kanengomibako/OwmPedal/OwmPedal_pic.jpg

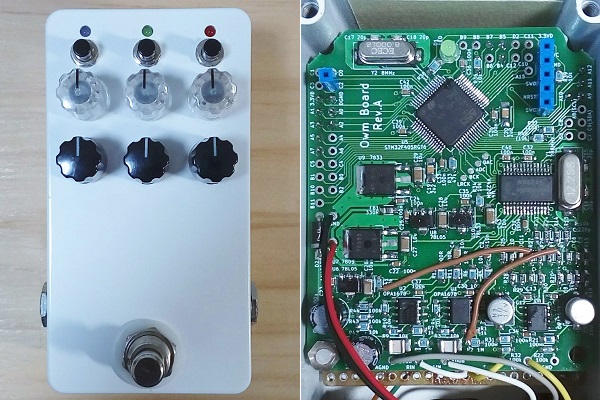
OwmPedal_pic.jpg
