kanengomibako/OwmPedal/README.txt

STM32F405 Digital Effects Pedal

STM32F405という32ビットマイコンを搭載した自作デジタルエフェクター「Owm Pedal」です。
