kanengomibako/OwmPedal/OwmBoard_sch.png

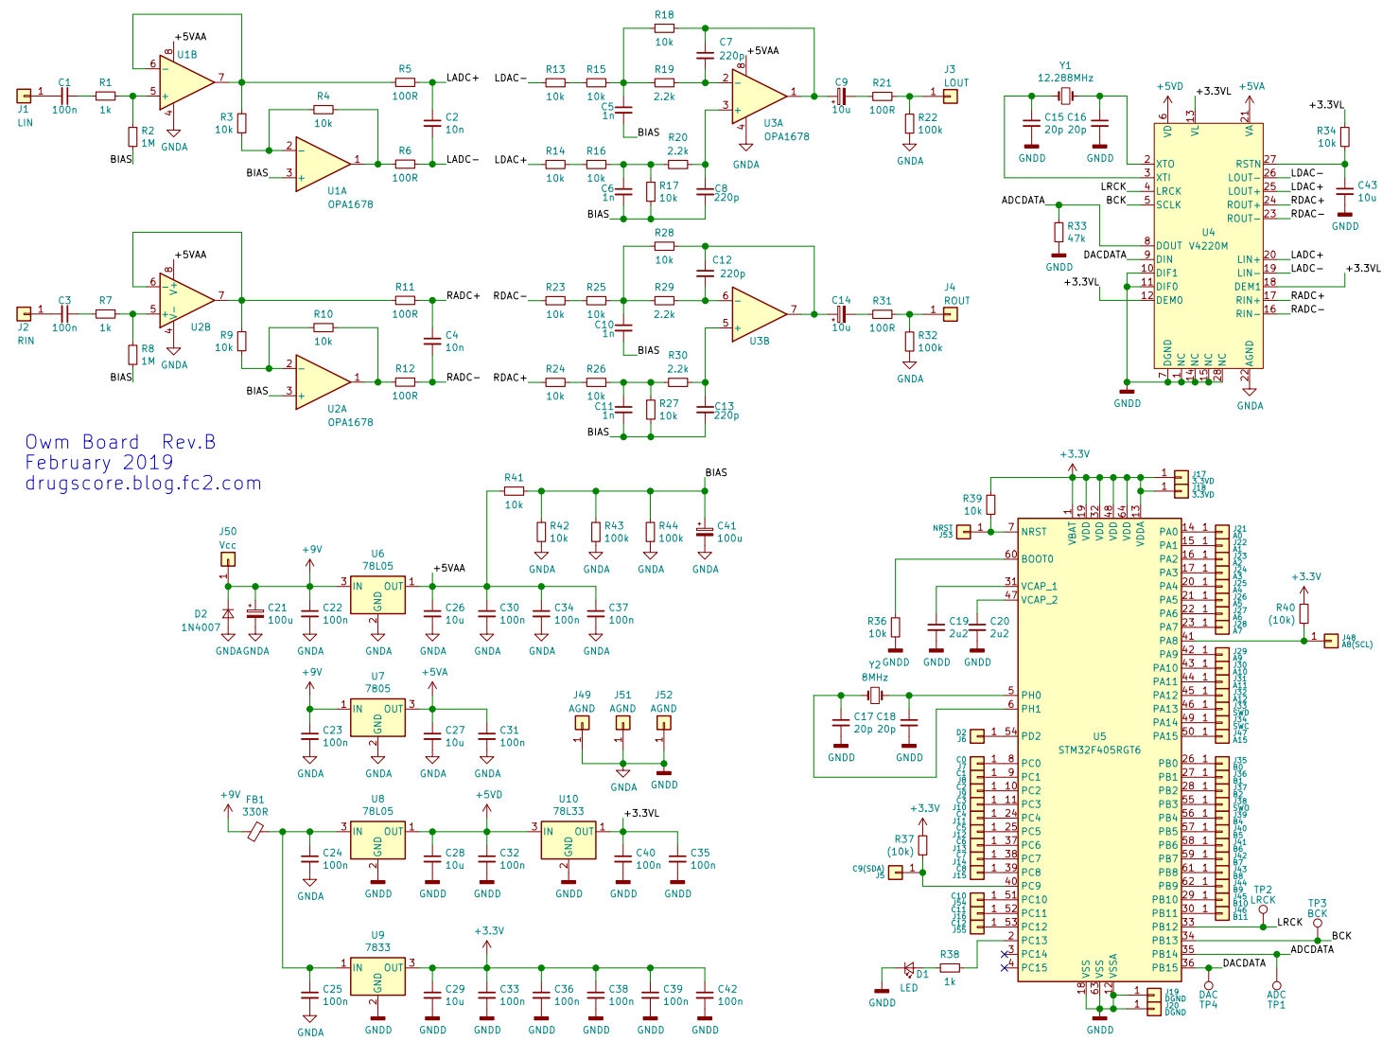
OwmBoard_sch.png
