kanengomibako/OwmPedal/KiCad/owm.kicad_pcb

## KiCad design KiCad/owm.kicad_pcb (2019-02-07)

Schematic: owm.sch

Parts:
C1, C3: 100n; my_C_3225(1210)_HandSoldering
C2, C4: 10n; my_C_1608(0603)_HandSoldering
C5, C6, C10, C11: 1n; my_C_1608(0603)_HandSoldering
C7, C8, C12, C13: 220p; my_C_1608(0603)_HandSoldering
C9, C14: 10u; my_CP_Elec_5
C15, C16, C17, C18: 20p; my_C_1608(0603)_HandSoldering
C19, C20: 2u2; my_C_3216(1206)_HandSoldering
C21, C41: 100u; my_C_D6.3mm_P2.50mm
C22, C23, C24, C25, C30, C31, C32, C33, C34, C35, C36, C37, C38, C39, C40, C42: 100n; my_C_1608(0603)_HandSoldering
C26, C27, C28, C29, C43: 10u; my_C_3216(1206)_HandSoldering
D1: LED; LED_D3.0mm
D2: 1N4007; D_DO-35_SOD27_P7.62mm_Horizontal
FB1: 330R; my_R_2012(0805)_HandSoldering
J1: LIN; my_SmallPad_0-8mmDrill
J2: RIN; my_SmallPad_0-8mmDrill
J3: LOUT; my_SmallPad_0-8mmDrill
J4: ROUT; my_SmallPad_0-8mmDrill
J5: C9(SDA); my_SmallPad_0-8mmDrill
J6: D2; my_SmallPad_0-8mmDrill
J7: C0; my_SmallPad_0-8mmDrill
J8: C1; my_SmallPad_0-8mmDrill
J9: C2; my_SmallPad_0-8mmDrill
J10: C3; my_SmallPad_0-8mmDrill
J11: C4; my_SmallPad_0-8mmDrill
J12: C5; my_SmallPad_0-8mmDrill
J13: C6; my_SmallPad_0-8mmDrill
J14: C7; my_SmallPad_0-8mmDrill
J15: C8; my_SmallPad_0-8mmDrill
J16: C11; my_SmallPad_0-8mmDrill
J17, J18: 3.3VD; my_SmallPad_0-8mmDrill
J19, J20: DGND; my_SmallPad_0-8mmDrill
J21: A0; my_SmallPad_0-8mmDrill
J22: A1; my_SmallPad_0-8mmDrill
J23: A2; my_SmallPad_0-8mmDrill
J24: A3; my_SmallPad_0-8mmDrill
J25: A4; my_SmallPad_0-8mmDrill
J26: A5; my_SmallPad_0-8mmDrill
J27: A6; my_SmallPad_0-8mmDrill
J28: A7; my_SmallPad_0-8mmDrill
J29: A9; my_SmallPad_0-8mmDrill
J30: A10; my_SmallPad_0-8mmDrill
J31: A11; my_SmallPad_0-8mmDrill
J32: A12; my_SmallPad_0-8mmDrill
J33: SWD; my_SmallPad_0-8mmDrill
J34: SWC; my_SmallPad_0-8mmDrill
J35: B0; my_SmallPad_0-8mmDrill
J36: B1; my_SmallPad_0-8mmDrill
J37: B2; my_SmallPad_0-8mmDrill
J38: SWO; my_SmallPad_0-8mmDrill
J39: B4; my_SmallPad_0-8mmDrill
J40: B5; my_SmallPad_0-8mmDrill
J41: B6; my_SmallPad_0-8mmDrill
J42: B7; my_SmallPad_0-8mmDrill
J43: B8; my_SmallPad_0-8mmDrill
J44: B9; my_SmallPad_0-8mmDrill
J45: B10; my_SmallPad_0-8mmDrill
J46: B11; my_SmallPad_0-8mmDrill
J47: A15; my_SmallPad_0-8mmDrill
J48: A8(SCL); my_SmallPad_0-8mmDrill
J49, J51, J52: AGND; my_SmallPad_0-8mmDrill
J50: Vcc; my_SmallPad_0-8mmDrill
J53: NRST; my_SmallPad_0-8mmDrill
J54: C10; my_SmallPad_0-8mmDrill
J55: C12; my_SmallPad_0-8mmDrill
R1, R7, R38: 1k; my_R_2012(0805)_HandSoldering
R2, R8: 1M; my_R_1608(0603)_HandSoldering
R3, R4, R9, R10, R13, R14, R15, R16, R17, R18, R23, R24, R25, R26, R27, R28, R34, R36, R39, R41, R42: 10k; my_R_1608(0603)_HandSoldering
R5, R6, R11, R12, R21, R31: 100R; my_R_2012(0805)_HandSoldering
R19, R20, R29, R30: 2.2k; my_R_1608(0603)_HandSoldering
R22, R32, R43, R44: 100k; my_R_1608(0603)_HandSoldering
R33: 47k; my_R_1608(0603)_HandSoldering
R37, R40: (10k); my_R_1608(0603)_HandSoldering
TP1: ADC; my_TestPoint_1.2mm
TP2: LRCK; my_TestPoint_1.2mm
TP3: BCK; my_TestPoint_1.2mm
TP4: DAC; my_TestPoint_1.2mm
U1, U2, U3: OPA1678; SOIC-8_3.9x4.9mm_P1.27mm
U4: V4220M; my_SSOP-28_5.3x10.2mm_Pitch0.65mm
U5: STM32F405RGT6; my_LQFP-64_10x10_P0.5
U6, U8: 78L05; SOT-89-3
U7: 7805; TO-252-3_TabPin2
U9: 7833; TO-252-3_TabPin2
U10: 78L33; SOT-89-3
Y1: 12.288MHz; Crystal_SMD_HC49-SD
Y2: 8MHz; Crystal_SMD_HC49-SD

Connections:
+3V3: C29.1, C33.1, C36.1, C38.1, C39.1, C42.1, J17.1, J18.1, R37.1, R39.1, R40.1, U5.1, U5.13, U5.19, U5.32, U5.48, U5.64, U9.3
+5VA: C27.1, C31.1, U4.21, U7.3
+5VD: C28.1, C32.1, U4.6, U8.1 (OUT), U10.3 (IN)
+9V: C21.1, C22.1, C23.1, D2.1, FB1.2, J50.1, U6.3 (IN), U7.1
/+3.3VL: C35.1, C40.1, R34.1, U4.12, U4.13, U4.18, U10.1 (OUT)
/+5VAA: C26.1, C30.1, C34.1, C37.1, R41.2, U1.8 (V+), U2.8 (V+), U3.8 (V+), U6.1 (OUT)
/ADCDATA: R33.1, TP1.1, U4.8, U5.35
/BCK: TP3.1, U4.5, U5.34
/BIAS: C5.2, C6.2, C8.2, C10.2, C11.2, C13.2, C41.1, R2.2, R8.2, R17.2, R27.2, R41.1, R42.1, R43.1, R44.1, U1.3 (+), U2.3 (+)
/DACDATA: TP4.1, U4.9, U5.36
/LADC+: C2.1, R5.1, U4.20
/LADC-: C2.2, R6.1, U4.19
/LDAC+: R14.2, U4.25
/LDAC-: R13.2, U4.26
/LRCK: TP2.1, U4.4, U5.33
/RADC+: C4.1, R11.1, U4.17
/RADC-: C4.2, R12.1, U4.16
/RDAC+: R24.2, U4.24
/RDAC-: R23.2, U4.23
GNDA: C15.2, C16.2, C17.2, C18.2, C19.2, C20.2, C21.2, C22.2, C23.2, C24.2, C25.2, C26.2, C27.2, C28.2, C29.2, C30.2, C31.2, C32.2, C33.2, C34.2, C35.2, C36.2, C37.2, C38.2, C39.2, C40.2, C41.2, C42.2, C43.2, D1.1, D2.2, J19.1, J20.1, J49.1, J51.1, J52.1, R22.2, R32.2, R33.2, R36.2, R42.2, R43.2, R44.2, U1.4 (V-), U2.4 (V-), U3.4 (V-), U4.1, U4.7, U4.10, U4.11, U4.14, U4.15, U4.22, U4.28, U5.12, U5.18, U5.63, U6.2 (GND), U7.2, U8.2 (GND), U9.2, U10.2 (GND)
unnamed: C1.1, R1.2
unnamed: C1.2, J1.1
unnamed: C3.1, R7.2
unnamed: C3.2, J2.1
unnamed: C5.1, R15.1, R18.2, R19.2
unnamed: C6.1, R16.1, R17.1, R20.2
unnamed: C7.1, C9.1, R18.1, U3.1
unnamed: C7.2, R19.1, U3.2 (-)
unnamed: C8.1, R20.1, U3.3 (+)
unnamed: C9.2, R21.2
unnamed: C10.1, R25.1, R28.2, R29.2
unnamed: C11.1, R26.1, R27.1, R30.2
unnamed: C12.1, C14.1, R28.1, U3.7
unnamed: C12.2, R29.1, U3.6 (-)
unnamed: C13.1, R30.1, U3.5 (+)
unnamed: C14.2, R31.2
unnamed: C15.1, U4.3, Y1.1
unnamed: C16.1, U4.2, Y1.2
unnamed: C17.1, U5.6, Y2.1
unnamed: C18.1, U5.5, Y2.2
unnamed: C19.1, U5.31
unnamed: C20.1, U5.47
unnamed: C24.1, C25.1, FB1.1, U8.3 (IN), U9.1
unnamed: C43.1, R34.2, U4.27
unnamed: D1.2, R38.1
unnamed: J3.1, R21.1, R22.1
unnamed: J4.1, R31.1, R32.1
unnamed: J5.1, R37.2, U5.40
unnamed: J6.1, U5.54
unnamed: J7.1, U5.8
unnamed: J8.1, U5.9
unnamed: J9.1, U5.10
unnamed: J10.1, U5.11
unnamed: J11.1, U5.24
unnamed: J12.1, U5.25
unnamed: J13.1, U5.37
unnamed: J14.1, U5.38
unnamed: J15.1, U5.39
unnamed: J16.1, U5.52
unnamed: J21.1, U5.14
unnamed: J22.1, U5.15
unnamed: J23.1, U5.16
unnamed: J24.1, U5.17
unnamed: J25.1, U5.20
unnamed: J26.1, U5.21
unnamed: J27.1, U5.22
unnamed: J28.1, U5.23
unnamed: J29.1, U5.42
unnamed: J30.1, U5.43
unnamed: J31.1, U5.44
unnamed: J32.1, U5.45
unnamed: J33.1, U5.46
unnamed: J34.1, U5.49
unnamed: J35.1, U5.26
unnamed: J36.1, U5.27
unnamed: J37.1, U5.28
unnamed: J38.1, U5.55
unnamed: J39.1, U5.56
unnamed: J40.1, U5.57
unnamed: J41.1, U5.58
unnamed: J42.1, U5.59
unnamed: J43.1, U5.61
unnamed: J44.1, U5.62
unnamed: J45.1, U5.29
unnamed: J46.1, U5.30
unnamed: J47.1, U5.50
unnamed: J48.1, R40.2, U5.41
unnamed: J53.1, R39.2, U5.7
unnamed: J54.1, U5.51
unnamed: J55.1, U5.53
unnamed: R1.1, R2.1, U1.5 (+)
unnamed: R3.1, R5.2, U1.6 (-), U1.7
unnamed: R3.2, R4.2, U1.2 (-)
unnamed: R4.1, R6.2, U1.1
unnamed: R7.1, R8.1, U2.5 (+)
unnamed: R10.1, R12.2, U2.1
unnamed: R9.2, R10.2, U2.2 (-)
unnamed: R9.1, R11.2, U2.6 (-), U2.7
unnamed: R13.1, R15.2
unnamed: R14.1, R16.2
unnamed: R23.1, R25.2
unnamed: R24.1, R26.2
unnamed: R36.1, U5.60
unnamed: R38.2, U5.2

Notes on the sheet:
Owm Board Rev.B February 2019 drugscore.blog.fc2.com

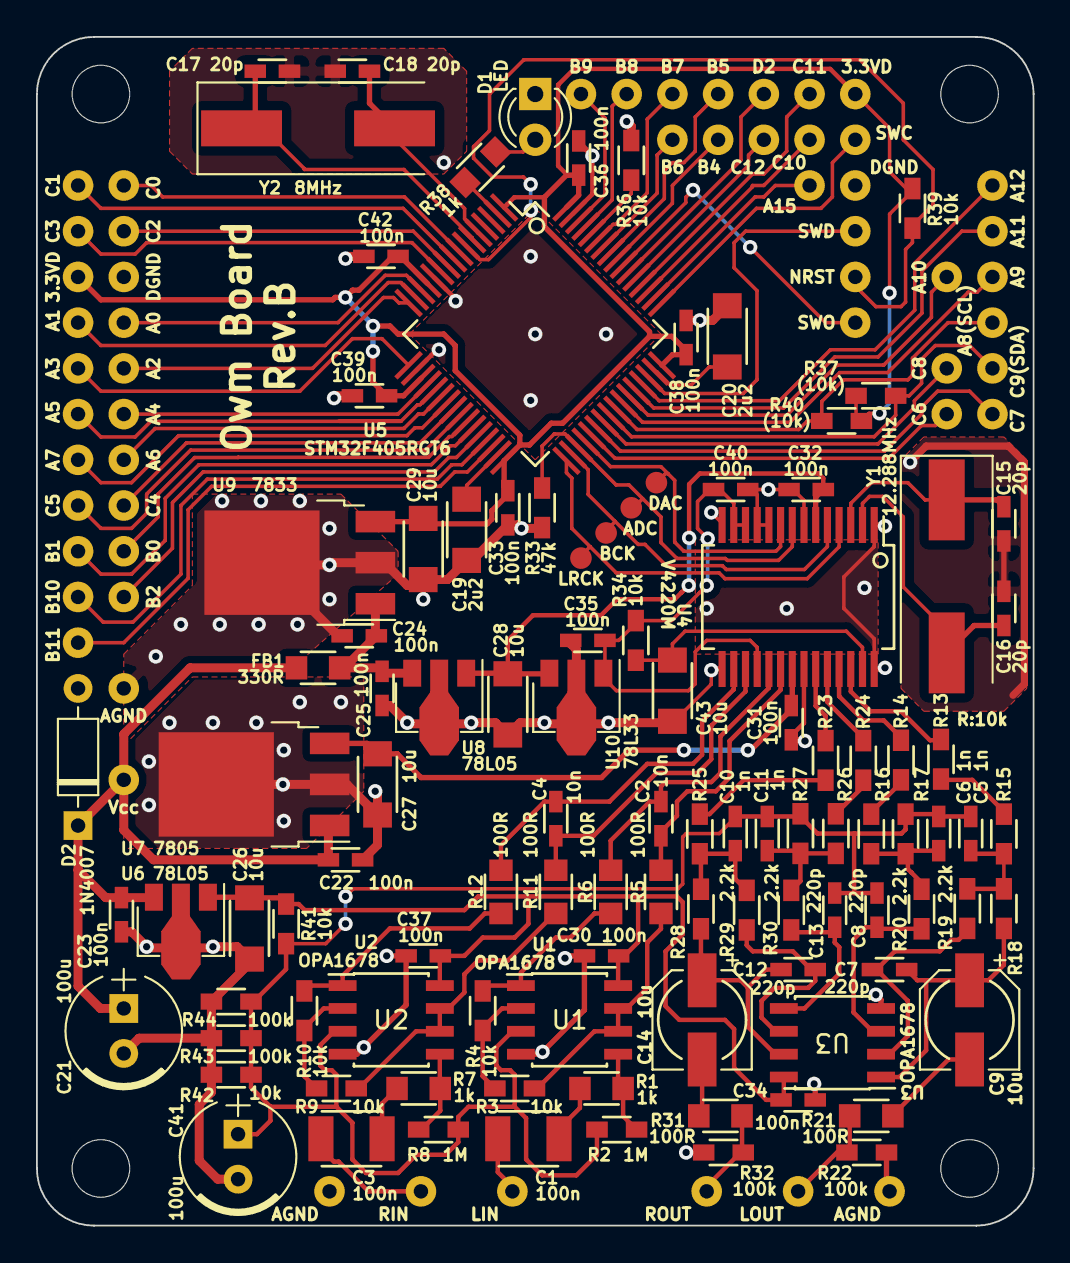
[picture p3: board owm.kicad_pcb from above]

Board: 2 copper layers, 55.4 x 66.0 mm, 160 parts (0 on the bottom side), 104 nets.
