kanengomibako/OwmPedal/Source/main.c

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

/* Includes ------------------------------------------------------------------*/
#include "main.h"

ADC_HandleTypeDef hadc1;
DMA_HandleTypeDef hdma_adc1;

I2S_HandleTypeDef hi2s2;
DMA_HandleTypeDef hdma_i2s2_ext_rx;
DMA_HandleTypeDef hdma_spi2_tx;

void SystemClock_Config(void);
static void MX_GPIO_Init(void);
static void MX_DMA_Init(void);
static void MX_ADC1_Init(void);
static void MX_I2S2_Init(void);
/* USER CODE BEGIN 0 */

volatile int32_t RX_BUFFER[BLOCK_SIZE*2] = {}; // 受信バッファ
volatile int32_t TX_BUFFER[BLOCK_SIZE*2] = {}; // 送信バッファ
volatile uint16_t pot[6] = {}; // ポット読取値
volatile uint8_t sw[4] = {};   // スイッチオン・オフ状態

/* USER CODE END 0 */

/**
  * @brief  The application entry point.
  * @retval int
  */
int main(void)
{
  /* MCU Configuration--------------------------------------------------------*/

  /* Reset of all peripherals, Initializes the Flash interface and the Systick. */
  HAL_Init();

  /* Configure the system clock */
  SystemClock_Config();

  /* Initialize all configured peripherals */
  MX_GPIO_Init();
  MX_DMA_Init();
  MX_ADC1_Init();
  MX_I2S2_Init();
  /* USER CODE BEGIN 2 */

  // I2SとADCのDMA開始
  HAL_I2SEx_TransmitReceive_DMA(&hi2s2,(uint16_t*)TX_BUFFER,(uint16_t*)RX_BUFFER,BLOCK_SIZE*2);
  HAL_ADC_Start_DMA(&hadc1, (uint32_t *)pot, 6);

  // 割り込みが受信と送信で2回発生しないよう片方の割り込みを無効化
  HAL_NVIC_DisableIRQ(DMA1_Stream4_IRQn);

  // I2Sのフレームエラー発生の場合、ソフトリセットを繰り返す
  HAL_Delay(300);
  if (__HAL_I2S_GET_FLAG(&hi2s2, I2S_FLAG_FRE)) NVIC_SystemReset();

  // 基板上のLED点灯（起動確認）
  HAL_GPIO_WritePin(GPIOC, GPIO_PIN_13, GPIO_PIN_SET);

  // スイッチ用カウンタ
  uint32_t swcount[4] = {};

  /* USER CODE END 2 */

  /* Infinite loop */
  /* USER CODE BEGIN WHILE */
  while (1)
  {
    /* USER CODE END WHILE */

    /* USER CODE BEGIN 3 */

    if (!(HAL_GPIO_ReadPin(GPIOA, GPIO_PIN_9))) // 左スイッチ
    {
      swcount[0]++;
      if (swcount[0] == 2 ) // スイッチ押下時スイッチ状態切替、LED点灯切替
      {
        sw[0] = !sw[0];
        HAL_GPIO_TogglePin(GPIOB, GPIO_PIN_5);
      }
    }
    else swcount[0] = 0;
    if (!(HAL_GPIO_ReadPin(GPIOA, GPIO_PIN_10))) // 中央スイッチ
    {
      swcount[1]++;
      if (swcount[1] == 2 )
      {
        sw[1] = !sw[1];
        HAL_GPIO_TogglePin(GPIOB, GPIO_PIN_7);
      }
    }
    else swcount[1] = 0;
    if (!(HAL_GPIO_ReadPin(GPIOA, GPIO_PIN_11))) // 右スイッチ
    {
      swcount[2]++;
      if (swcount[2] == 2 )
      {
        sw[2] = !sw[2];
        HAL_GPIO_TogglePin(GPIOB, GPIO_PIN_4);
      }
    }
    else swcount[2] = 0;
    if (!(HAL_GPIO_ReadPin(GPIOA, GPIO_PIN_12))) // フットスイッチ
    {
      swcount[3]++;
      if (swcount[3] == 2 )
      {
        sw[3] = !sw[3];
        HAL_GPIO_TogglePin(GPIOB, GPIO_PIN_7);
      }
    }
    else swcount[3] = 0;

    HAL_Delay(1);
  }

  /* USER CODE END 3 */
}

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
/* USER CODE BEGIN 4 */

// DMA用に上位16ビットと下位16ビットを入れ替える
// 負の値の場合に備えて右シフトの場合0埋めする
int32_t swap16(int32_t x)
{
  return (0x0000FFFF & x >> 16) | x << 16;
}

void processing(int i)
{
  static float xl[BLOCK_SIZE] = {}; // Lch float計算用受信データ Rchは未使用
  static float yl[BLOCK_SIZE] = {}; // Lch float計算済送信データ

  // 受信データを計算用データ配列へ 値を-1～+1(float)へ変更
  xl[i] = (float) swap16(RX_BUFFER[i*2]) / 2147483648.0f;

  // エフェクト処理後、値を制限
  yl[i] = fmaxf(fminf(bypass(xl[i]), 0.99997f), -1.0f);

  // 計算済データを送信バッファへ 値を32ビット整数へ戻す
  TX_BUFFER[i*2] = swap16(2147483648.0f * yl[i]);
}

// I2Sの受信バッファに半分データがたまったときの割り込み
void HAL_I2SEx_TxRxHalfCpltCallback(I2S_HandleTypeDef *hi2s)
{
  for (int i = 0; i < BLOCK_SIZE/2; i++) processing(i);
}

// I2Sの受信バッファに全データがたまったときの割り込み
void HAL_I2SEx_TxRxCpltCallback(I2S_HandleTypeDef *hi2s)
{
  for (int i = BLOCK_SIZE/2; i < BLOCK_SIZE; i++) processing(i);
}

/* USER CODE END 4 */
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
