kanengomibako/OwmPedal/(commit log)

2019-03-04 Source追加
2019-03-07 Priority変更
2019-03-19 Update stm32f4xx_hal_i2s_ex.c
    HAL_I2SEx_TxRxCpltCallbackが起きない不具合を修正
2019-03-22 Update main.c
    HAL_I2SEx_TxRxCpltCallbackを追加し処理方法を変更
2019-03-29 I2Sを32ビットへ変更
