kanengomibako/OwmPedal/(notices)

Notices in the files:
Source/main.c:
COPYRIGHT(c) 2019 STMicroelectronics
(C) COPYRIGHT STMicroelectronics *****END OF FILE
